ggajoch/eng-thesis/07_engineeringModel.tex

\chapter{Engineering model}
This chapter will describe engineering model developed during this thesis.

This model should be as close to flight model as possible - but it could be e.g. on separate board, which is this case.

This model was developed as flight-ready version for sensor calibration \& tests along with developing \& testing flight software.

\section{Block diagram}

\section{Low-level requirements}

\section{Analog front-end}
\subsection{Current source}
\subsection{ADC}
\subsection{Multiplexer}
\subsection{LDO}
\subsection{Shielding}

\section{Digital}
\subsection{Microcontroller}
\subsection{OBC interface}

\section{Software design}
\subsection{AVR-HAL}
\subsection{I2C-slave module}
\subsection{Measurement algorithm}

\section{PCB}
\subsection{PCB stack}
\subsection{PCB layout}
\subsection{3D model}
\subsection{Manufacturing}

\section{Assembly}

\section{Finished sensor}
