ggajoch/eng-thesis/img/05/conceptual_block_diagram.asc

I1: current
M1: pmos
Named nets: 0
ADC
µC
OBC
