ggajoch/eng-thesis/img/06/current_source_schematic.asc

R1: res
R2: res
U1: LT1634-1.25
U2: opamp
Named nets: COM, OUT
Vref
