ggajoch/eng-thesis/img/06/current_source.asc

C1: cap; 100n
R1: res; 5k
R2: res; 10k tc={TC}
R3: res; 20k
R4: res; 20k
U1: LT1634-1.25
U2: LTC2054
V1: voltage; 4.5
Named nets: COM, 0
.dc temp 0 60
.step param TC list -5e-6 5e-6
