ggajoch/eng-thesis/img/05/n-mos-temperature.asc

I1: current
M1: nmos
Named nets: 0
ADC
µC
OBC
