ggajoch/eng-thesis/(list of files, drawings)

Other design files:
img/PC-104.SchDoc
