ggajoch/eng-thesis/(commit log)

2016-11-21 Sensor requirements chapter first issue
    [PC-104.SchDoc]
2016-11-23 sensor design first issue
2016-12-06 prototypes & MG thesis
2016-12-15 sensor design - added block diagrams
2016-12-16 MG fixes; moved calibration model to eng
2016-12-21 PCB and software description
2017-01-02 Sensor design
2017-01-07 finished sensor photo
2017-01-07 PC104 board
2017-01-08 images cleanup
    [PC-104.SchDoc]
